e-kagaku/experimentDroneFalling/img/body_arduino.jpg

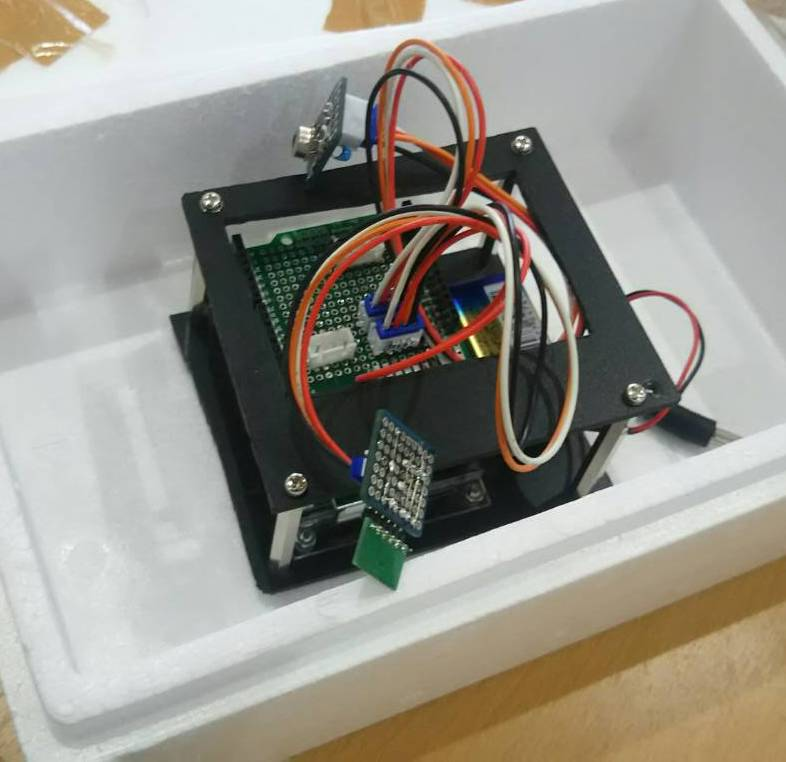
img/body_arduino.jpg
